Smee-code/SmartHoseLeak/(commit log)

2026-09-08 Replace firmware with merged WiFi-portal + server-uplink sketch
    The two sketches had diverged: the repo copy could POST readings to the
    Django server but had WiFi credentials compiled in, while the newer field
    sketch added a captive-portal WiFi setup but no longer talked to the server
    at all. Flashing the latter would have left the dashboards permanently
    empty, since /api/ingest/ is the only writer of LatestReading, ReadingRollup
    and LeakEvent.
    Merge the uplink into the portal sketch and retire the old one:
    - buildPayload() adapts buildStatusJSON() to the ingest contract, keying
    readings by "module" and the calibration constant by "k"
    - uploadReadings() POSTs on its own timer, skipped in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
    [water_leak_detection_3modules_gsm_wifi.ino]
2026-09-08 Auto-format sketch and set the real device API key
    Applied the IDE's Auto Format (braces moved to their own line, Allman
    style) and filled in the live DEVICE_API_KEY so the sketch is flashable
    straight from the repo without an edit step.
    The formatting is cosmetic: no behavioural change, and it still compiles
    for esp32:esp32:esp32 on core 3.3.11 at 83% program storage.
    Note the key is now in the history. The repo is private, and the key is
    rotatable from the Django admin under Devices if it ever needs revoking.
2026-09-11 Side navigation, map overhaul, CRUD dialogs, and a device-configurable server URL
    A day of work on the facilitator side. Grouped by area:
    NAVIGATION
    - Move the main nav from a crowded top row into a sidebar, grouped
    Monitoring / Management. Below 1024px it becomes an off-canvas drawer
    with a scrim, focus trap, Escape-to-close and a locked background.
    - Responsive pass across every page: no horizontal scroll at any width
    down to 320px. Fixed grid children with min-width:auto letting a wide
    table push the whole page past the viewport.
    LEAK MAP
    - Draw the real municipal boundary of Sison from the official NAMRIA/PSA
    outline, served locally so the map frames the right place with no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
2026-09-11 Toast notifications for server messages, device IP on dashboard, footer design
    - Django messages now surface as toasts instead of a bar across the page.
    They pause while hovered, and anything carrying a password or username
    waits to be dismissed rather than timing out - a temporary password
    vanishing after eight seconds would have lost it for good.
    - The Device status card shows the ESP32's IP as a link to the board's own
    page, kept current by the live poll. Both the laptop's and the board's
    addresses change with the network, and confusing the two is what sends
    you to the wrong /wifi page.
    - The site footer had no styles at all beyond a print rule, so it rendered
    with browser d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
2026-09-11 Complaints become threaded conversations
    Replaces the single-reply ticket screen with a message inbox on both sides.
    A complaint now carries a thread of messages instead of one `response`
    field, so the facilitator and the owner can go back and forth.
    WHY THE ISSUE STAYS THE UNIT
    Grouping strictly by household was considered and rejected: a household
    that reports a leak in March and low pressure in June needs those resolved
    independently, and the dashboard's "Pending complaints" count only means
    something if status belongs to a problem rather than to a person. The
    inbox reads like a messenger; the thread is still one issue.
    - ComplaintMessage: body, author, from_owner, and a read flag per s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
2026-09-11 New complaint moves to a button and a dialog
    The only way to start a complaint was a small "File a different complaint"
    link under the reply box, which is easy to miss and only present once a
    thread is already open.
    - A "New complaint" button now sits in the page header, reachable whether
    or not a conversation is open.
    - The form moved into a dialog, so starting a complaint no longer replaces
    the conversation pane.
    - The empty pane became a proper empty state that also offers the button,
    and reads differently for someone who has never filed anything.
    - The dialog posts to the list URL rather than the current one, so it
    behaves identically from either place, and reopens with the type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
2026-09-11 Redesign the notices list as a grouped timeline
    The list was a stack of identical bordered cards, each repeating its own
    kind in grey text underneath. Nothing distinguished an automated leak alert
    from a reply, and a long list read as a wall.
    - Grouped by day, with Today / Yesterday headings.
    - A timeline rail with an icon node per notice, coloured by kind: red
    warning for automated alerts, blue bell for broadcasts, green chat for
    replies. The icon carries the meaning, so the kind no longer needs a line
    of text under every card.
    - Unread notices are outlined and tagged New. The read flag is now sampled
    before it is cleared, so "new since you last looked" survives the visit
    that ma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
2026-09-11 Search box on the complaints list
    Narrows the conversation list as you type, matching the household owner's
    name or the household ID.
    - Filters the rows already on screen rather than asking the server, so it
    responds on every keystroke and naturally searches *within* the selected
    status chip instead of fighting it.
    - Sticky at the top of the list, so it stays reachable once the list is
    long enough to scroll.
    - Escape clears it, as does the native clear button on a search input.
    - Says "No conversation matches that" rather than leaving an empty box.
    The list already scrolled inside itself at 70vh; confirmed with eight
    threads that it scrolls and the search box stays pinned above them.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
2026-09-11 Drop the footer on the owner's complaints page
    The page ends in the message box, and on a phone a footer underneath pushed
    the compose field up and left a screen of credits below a conversation.
    The footer moved into a template block so a page can opt out; the owner's
    complaints page overrides it with nothing. Every other page keeps it.
    Verified at phone width: no footer on the thread, the page no longer
    scrolls past the viewport, and Home, Notices and My Pressure still have it.
2026-09-11 Back button becomes an inline arrow instead of its own row
    A wide "<- Back" button with no flex-basis on the title next to it meant the
    title wrapped onto a second line, leaving the button stranded above the
    heading on a phone.
    It is now a 32px circular arrow immediately left of the title, the way a
    phone detail screen usually reads, and the title has a flex-basis so it
    stays on that line. Applied to both the owner's and the facilitator's
    conversation, and still hidden on desktop where the list is already beside
    the thread.
2026-09-12 Make the pressure sensors diagnosable from the serial line
    The board was reporting 0.00 bar on all three modules and there was no way
    to tell whether that meant "no water pressure" or "no sensor" - a correctly
    wired transducer outputs 0.5 V at rest, which converts to exactly 0.00 bar,
    the same as an unconnected pin. Nothing in the firmware exposed the raw ADC
    count, which is the only thing that separates them.
    Taking sensor_test.ino as the reference, which does show raw counts:
    - Average 16 ADC samples per reading instead of one. A single ESP32 read
    swings by hundreds of counts; this is what makes the reference sketch's
    numbers steady.
    - Put the raw count and both voltages on every ser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
    [water_leak_detection_3modules_gsm_wifi.ino]
2026-09-12 Calibrated ADC reading and a per-sensor zero point
    With the raw counts now visible, all three sensors read ~350 counts steadily
    - a real signal, not a dead pin. But that converts to 0.423 V at the sensor,
    below the 0.5 V the datasheet calls zero, so every reading clamped to 0.00
    bar and the bottom ~0.3 bar of range was unreachable.
    Two causes, both addressed:
    - The raw count was being converted by hand, which assumes a perfectly
    linear 0-3.3 V ADC. The ESP32's is not; it reads low, worst at the bottom
    of the range, which is exactly where a pressure sensor sits with no water.
    analogReadMilliVolts() applies the calibration burned into the chip at the
    factory instead of assuming.
    - S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
    [water_leak_detection_3modules_gsm_wifi.ino]
2026-09-12 Put SQLite in WAL mode to stop "database is locked" dropping readings
    The ESP32 posts every two seconds and every open dashboard polls just as
    often. SQLite allows a single writer, and the database sits on a USB drive
    where writes are slow, so those collided: the loser raised "database is
    locked", the ingest returned 500 and that batch of readings was lost.
    - journal_mode=WAL lets readers carry on while a write is in progress,
    which removes nearly all of the contention.
    - synchronous=NORMAL is the matching setting under WAL: still crash-safe,
    without an fsync per transaction, which is what hurts most on removable
    media.
    - busy timeout raised from the default 5s to 30s, so a slow write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
2026-09-14 The ESP32 finds the server by itself
    The laptop's address comes from whatever router it joins, so it moves - four
    times in one day here. Each time, the board kept posting readings to the old
    address until somebody noticed and retyped it, and today that meant two days
    of silence with the dashboard showing stale values.
    The board now asks instead. It broadcasts a probe, the server answers with
    the address to use, and the board saves it to flash.
    - Server: a small UDP listener on 18830, started by runserver only when
    bound to all interfaces - on localhost there is nothing for a device to
    find, and advertising an unreachable address would be worse than silence.
    It answers with the addres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
2026-09-14 Show the connection on the device's own dashboard
    The board's page said only "WiFi: Connected" - not which network, not its own
    address, not where it was sending readings. Those are exactly the things that
    change without anyone touching the board: the network when it is moved, the
    server address when the laptop's address moves.
    The page now opens with a panel giving:
    Network the SSID it joined, with signal strength in words and dBm
    This device its own IP
    Sending to the server address currently in use
    Last upload the result, and when that failed, what the last search for
    the server turned up
    So "why is the dashboard not updating" is answerable from one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
    [water_leak_detection_3modules_gsm_wifi.ino]
2026-09-14 Set the low-supply threshold from the dashboard, not the sketch
    The pressure at which a line counts as "low supply" is a property of the
    site, not of the code. A gravity-fed line sits at roughly 1 bar per 10 m
    its source is above it, so the right figure differs from line to line and
    is only knowable once the line exists and has been watched for a day.
    It was a single compiled-in constant at 1.5 bar - a value that suits a
    pressurised municipal main. A healthy gravity-fed barangay line runs at
    0.3-1.0 bar, so all three lines reported Low Water Supply permanently and
    the alert became noise. Changing it meant a laptop, a cable and a reflash.
    Now each line owns its own threshold, editable at Da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
    [water_leak_detection_3modules_gsm_wifi.ino]
2026-09-16 One hose line per household, each with its own device
    The rig was three sensor pairs sharing one board along a single run, so a
    household was assigned to whichever stretch it happened to sit on and a leak
    could only be narrowed to "somewhere between 15 m and 30 m". Each house now
    has its own hose from the main source and its own board. A leak is
    attributed to a household instead of to a position - more useful, because it
    names a door to knock on, and more honest, because two sensors at one end of
    a pipe cannot locate a hole along it.
    Distance markers, length and "leak location" are gone throughout. They
    described the old geometry and describe the new one not at all.
    The dashboard's three c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
    [mark_offline.py]
2026-09-16 The map draws one hose per household, from the main source
    Every household now has its own hose leaving one point, but the map was
    still grouping houses by module and chaining each group into a single run.
    With one board per house every line reports module 1, so all six households
    collapsed onto one branch - drawing plumbing that does not exist, and
    implying that a leak upstream affects everyone below it.
    Each hose is now drawn straight from the source to its own house, in that
    household's colour. A hose with no board fitted is dashed: the pipe is
    there, nothing is watching it, and that has to read as "not yet" rather than
    as a fault.
    The recorded source is renamed from "Main valve" to "Ma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
2026-09-16 Send notices by SMS, and text a household when their line leaks
    An in-app notice is only seen by somebody who opens the app. A leak at two
    in the morning cannot wait for that, so the household is now texted as well.
    Through a SIM800L on the SERVER, not the one on the board. The board's module
    knows module numbers and bar readings; the household database lives here, so
    this is the only place that can address a message to a named person and write
    a sentence they can act on. The board's module stays as a last resort for
    when it cannot reach the server at all.
    One compose screen, two channels, rather than a separate SMS tab. A
    facilitator writing "water is off until 3pm" is doing one thing, an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
    [runserver.py, send_sms.py]
2026-09-16 Drop the single Device status tile from the dashboard
    It described one board. There is now one per household, so a single global
    answer could only be wrong or meaningless - and the Households table below
    already answers the same question per house, which is the resolution that
    actually matters when deciding whose water is unwatched.
    The board's IP address is not lost with it: it moves into that table's
    Device column, under "live", still a link to the board's own page and still
    kept current by the poll. The address changes whenever the network does, and
    that is exactly when somebody needs to open it.
    The offline toast stays. A board dropping off is worth interrupting for
    wherever the facili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
2026-09-16 Register a household, its hose and its board in one action
    Adding a house, laying its hose and fitting its board is one real-world
    event. It took four steps across three screens plus the Django admin - and
    the last step was impossible from the UI at all, since a board could only be
    created in /admin/, which was also the only place its key could be read.
    Three screens is how a household ends up on the books with no line and
    nobody notices for a week.
    The "Supply line" dropdown is gone from the household form. A line serves
    exactly one house now, so picking one from a list of lines that each belong
    to another house was a question with a single right answer; the line is
    created with the househ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
2026-09-16 Per-household firmware: one sensor pair, four tests, a valve, and a claim code
    The board now watches one household's hose and is told who it is, instead of
    carrying three sensor pairs and a compiled-in identity.
    Identity comes from a claim code. The API key is 43 mixed-case characters
    with dashes and underscores, and asking somebody to type that on a phone in
    a yard produces a 401 - which on the serial monitor is indistinguishable
    from a wrong server address. Instead the dashboard issues a six-character
    single-use code, the board hands it to /api/claim/ once it is on the network,
    and the server hands back the real identity, which the board keeps in flash.
    The key is never typed, never copie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
    [water_leak_detection_3modules_gsm_wifi.ino]
2026-09-16 Bring the runbook in line with the firmware it describes
    Section 9 still told the operator to calibrate with C1 / A / F before
    trusting any leak alert. Those commands do not exist any more, and neither
    does the method behind them - so the first thing the guide asked for was
    impossible, which is worse than saying nothing. It now covers the commands
    the sketch actually has: zeroing, the valve, and simulation.
    Section 15 was a plan for "one ESP32 per zone, three lines each", written
    when the rig shared a board between lines. The design passed it. It now
    records what the system actually does, including why boards are numbered
    separately from households and the one part that genuinely does not s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
2026-09-16 Let the board run correctly before the valve and GSM arrive
    The sensors are wired and the valve and SIM800L are not, and a board in that
    state has to behave correctly rather than almost correctly. Two switches,
    because both failure modes are quiet ones.
    With no valve, the sealed-line test would close nothing, then time the
    pressure drift of an OPEN hose for five minutes and report it as a leak.
    Phantom leaks are worse than no leak detection: they teach everyone to ignore
    the alerts, including the real ones. The test is the only one of the four
    that needs the valve, so the other three keep running.
    With no GSM module, every AT command waits out a timeout that never ends,
    inside a loop that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
    [water_leak_detection_3modules_gsm_wifi.ino]
2026-09-16 Send SMS through Semaphore instead of a modem on this machine
    The SIM800L was the right choice while the server was a laptop: nothing per
    message on an unli-text promo, and it works with no internet at all. It
    cannot survive hosting. pyserial opens a port on the machine executing the
    code, so the modem and the server have to be the same machine - a container
    in a data centre has no USB port, and no amount of plugging the module into
    a laptop in Surigao changes that. A gateway works from both, so one build
    now serves the prototype and any deployment with nothing to migrate.
    What is given up is SMS during an internet outage, which is exactly when it
    matters most. The answer is the SIM800L on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
2026-09-16 Show unread conversations the way a message list does
    The inbox marked an unanswered thread with a small count badge, in a row that
    already carries an avatar, a name, a date, a subject and a status pill. It
    was easy to scan straight past - and the one question this list has to answer
    without being read is "has somebody written to me and not been answered".
    An unread row now gets weight, colour and a dot at once: a tinted background,
    a bar down its left edge so the unread ones line up as a column rather than
    each having to be judged on its own, a bold name and subject, and the count
    kept because how many is more use to a facilitator triaging than a plain dot.
    The open thread wins over the u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
2026-09-16 Stop a conversation filling the Recently sent panel
    Every reply written in a complaint thread also becomes a notice for that
    owner, and each one was rendered as a full card: a title like "Reply to your
    complaint CMP-260911-96A2" wrapped around a body of "ok". The list meant for
    notices the facilitator composed was, in practice, made entirely of them -
    seven short replies filled the panel, and it grew with every reply ever sent.
    Replies are now one compact row each, linking to the thread, because the
    thread is where a reply can actually be acted on. Consecutive replies to the
    same complaint fold into one row with a count of the rest. Only consecutive
    ones: a run broken by something else is t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
2026-09-16 Compact the compose form so the whole of it fits on screen
    Choosing recipients, writing a notice and sending it is one short task, and
    it filled a tall column: seven households in a 190px scrolling box that
    showed five of them, a five-row message box, two checkboxes each with a
    paragraph beneath, a button, and two more paragraphs of advice.
    Households now wrap across the width. Seven fit in two rows with nothing
    hidden and no scrollbar; the cap only bites past roughly twenty, where a full
    list would be the thing pushing the message box off the screen.
    The two channels and the send button share one line. Deciding where a notice
    goes and sending it are one action, and stacking them put three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
2026-09-16 Choose recipients by typing, not by hunting a checkbox grid
    A grid of checkboxes was fine at seven households and stops working at the
    twenty to fifty this is meant to serve: finding one becomes hunting, and the
    compose form grows with the barangay.
    A modal would have solved the space and cost something else - the choice
    would sit behind a dialog, so you could not see who you had picked while
    writing the message, and the most common action would gain a click.
    So: a token field. Type to filter on name or household ID, Enter or a click
    adds a chip, the x removes one, Backspace in an empty box removes the last.
    Chips stay in view beside the message. "All active households" stays a
    single tick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
2026-09-16 Compact the two panels on a household's page
    household, so their own page is where all of their replies land together -
    and each was a card wrapped around one line like "ok". Five complaints and
    seven notices ran past the bottom of the screen.
    Both panels are rows now, and the notices reuse the folding already built
    for the Notices page: consecutive replies to the same complaint become one
    row with a count. Seven notices render as four rows; the pair of panels is
    349px and the page fits in 880.
    _recent_notice_feed() takes a queryset so this page can pass the household's
    own notifications through the same folding rathe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
2026-10-01 Keep the frontend-design skill with the project
    Installed from anthropics/skills. It is design direction rather than code:
    a two-pass process that makes you write a palette and type plan and check it
    for genericness before building, a calibration list of the traits that mark
    generated design, and guidance on interface writing.
    Committed so it travels with the repository. Until now it existed only on
    this drive, and a clone elsewhere - or a drive failure - would have meant
    re-running the installer to get it back.
    The installer also wrote .agents/skills/, a second copy for Cursor, Copilot
    and similar. That one is ignored: this project is worked on through Claude
    Code, which reads .claude/ski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
2026-10-01 Stop the pressure tab saying everything twice
    Seven tiles across the top showed the same seven households, the same
    pressure, the same flow and the same status as the seven rows below them.
    Both are kept, as asked - they now answer different questions. The tiles are
    what is reading NOW. The table is the record: every household, the psi and
    the links to each one, which the tiles never carried.
    A tile with no reading collapses to its own name. Six cards of four empty
    wells buried the one line that was live and made a rollout going to plan look
    like six faults; a card's size should be how much it has to say. The
    collapsed state is cleared by the poll the moment a reading arrives, so a
    line tha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
2026-10-01 Make the households page about the households
    Seven saturated red Delete buttons ran as a stripe down the right edge of a
    page whose job is to show people, sending the eye straight to the one action
    nobody opens this page to take. Delete stays exactly where it was and does
    exactly what it did - it now rests as a quiet control and turns red the
    moment it is hovered or focused. Verified: transparent at rest, #b3261e on
    hover AND on keyboard focus, and the confirmation dialog still carries a full
    danger button, which is where the weight belongs.
    The Supply line column is every row's id and owner run together - "HH-001 -
    Maria Santos" sitting beside HH-001 and Maria Santos. It is the line's rea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
2026-10-01 Redesign the lines page, and unbreak three lines while doing it
    The page announced itself as "Supply lines and distance markers" and then
    explained that "each line is one sensor module on the ESP32" and that the
    water source "is the 0 m mark". None of that has been true since one board
    per household: distance markers are gone and a leak names a household. A
    heading that describes something the system does not do is worse than none.
    Three of the seven lines could not be saved at all. 0012 rebuilt the lines
    with a hardcoded list of hex values rather than reading DEFAULT_COLOR_CYCLE,
    and three were not in the palette the form offers - so Edit showed no colour
    selected, and Save returned "Selec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
2026-10-01 Make a complaint thread about the problem, not the person
    The inbox listed five rows all reading "Maria Santos" with the thing that
    told them apart - the subject - set in grey underneath. A thread here is
    one problem, and one household can have five open at once, so the subject
    now leads and the name follows it. The thread header was reordered to
    match, so the row clicked is the row now at the top.
    The context strip read "HH-001 - Purok 1, Lower Dakong Patag - HH-001 -
    Maria Santos - +639171234567": the household id twice, the owner again.
    It is now the household link, the address, and the number as a tel: link
    pushed to the right, which is what the facilitator reaches for mid-read.
    Timest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
2026-10-01 Make the landing page about water, and stop it naming residents
    The public page opened with a tracked-out locale label, a centred headline
    over a pale gradient, three big-number cards and four identical rounded
    cards holding a dot, a triangle, a flag and an envelope. Nothing on it was
    about water; swap the nouns and the same page sells a parcel tracker.
    The hero is now the one idea the system runs on, drawn: pressure holding
    steady through the night and then sliding away while no tap is open. That is
    what each board watches for, it is why the project exists, and it lands
    before a word of the copy is read. Inline SVG, because this is a PWA with an
    offline page installed on phones where the s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
2026-10-01 Let card heads wrap, so a control cannot push out of its own card
    On the Lines page at phone width, "Register a board" and its label field ran
    out through the right edge of the Devices card and landed on the table
    below. The head measured 346px of content inside a 337px card.
    Fixed where it comes from rather than on that page. .card-head was a flex
    row with no wrap anywhere in the system, which left it no way to fail but to
    push its control through the card edge - every card head carrying a button
    had the same bug waiting at some width, and the heading and the control are
    not one indivisible line. There is no width at which overflowing beats
    dropping to a second row.
    .inline-form had the s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
2026-10-01 Fix the sidebar logo, hidden behind a comment that was not one
    I broke this in the routing change. Django's {# #} comment is single-line
    only; written across two lines it is not a comment at all, it is text. The
    note I left above the sidebar brand therefore rendered - four lines of
    commentary beside the logo, pushing it from x=14 to x=202 and out of the
    header, on every signed-in page for both roles. The markup looked correct,
    which is exactly why it got through.
    Both of my multi-line {# #} comments are now {% comment %} blocks. The other
    was inside the landing page's SVG, where the stray text happened not to
    paint, so nothing showed - it was the same mistake with a luckier outcome.
    Added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
2026-10-02 Give wrong addresses a real page instead of a traceback
    A mistyped address produced Django's development error page, which besides
    looking like a fault printed every URL pattern in the project to whoever
    typed it - api/claim/, the device key endpoints, all of it. With DEBUG off
    it would have produced Django's bare "Not Found" instead, which is not much
    better. Four pages now: 404, 403, 400 and 500.
    No giant status numeral. That is the stock treatment and it puts a protocol
    code at the largest size on the screen, above the sentence that says what
    actually happened. The code is at the bottom, small, because it is what gets
    quoted when somebody reports the problem and nothing else about it is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
2026-10-02 Name the https trap where it happens, instead of in a stack trace
    Opening the LAN address on a phone produced ERR_SSL_PROTOCOL_ERROR and filled
    the server window with "code 400, message Bad request version
    ('\x16\x03\x01...')". Those are the same event said twice: the browser sent a
    TLS handshake and this server read it as a request line. Nothing in the
    project is wrong - it serves HTTP, returns 200, sends no HSTS header, no
    upgrade-insecure-requests and has no SSL redirect - and no server-side
    setting can stop a browser choosing https.
    So the startup banner now says so next to the address it prints, which is
    where somebody is standing when they get it wrong, and GUIDE 12e carries the
    sympt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
    [runserver.py]
2026-10-02 Trust ngrok's current domain for CSRF, and write down how to use it
    VS Code's port forwarding delivered static files but silently dropped every
    HTML page - app.css arrived over the tunnel, /login/ never did, while both
    answered instantly on 127.0.0.1 and on the LAN. That is not something this
    project can fix, so the guide now covers ngrok as the way to put the system
    on a phone.
    ngrok hands out *.ngrok-free.dev now, not the *.ngrok-free.app this list was
    written against, so the first login through it would have failed the CSRF
    origin check - and that failure says nothing about the tunnel being the
    cause, which is the whole reason this block exists. Both are trusted now,
    and the old .ngrok.i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
2026-10-02 Take the house count out of the headline, where it was already wrong
    The hero read "Seven houses." The barangay is on six lines now, so the one
    sentence nobody thinks to edit was contradicting the live counts sitting
    directly underneath it. A number carved into a headline goes stale on its
    own and makes the whole page look unmaintained.
    It now describes the shape of the system instead, which does not change with
    the roll-out: one hose to every house, a sensor on every hose. The counts
    stay in the strip below, where they come from the database and are right by
    construction.
    Also fixed the labels in that strip, which were fixed words beside a live
    number and read "1 Boards fitted" - exactly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
2026-10-05 Rebuild the landing page as an instrument, for the defence panel
    The page read as generated: a big-number/small-label count strip (the stock
    hero treatment), system type with no personality, rounded role cards, and a
    chart that sat on the page rather than being the point of it. This rebuilds
    it around one idea - the page is the face of a chart recorder, and the one
    pattern the whole system turns on is drawn on it: pressure sliding away while
    no tap is open.
    Direction, type, hero and audience were chosen with the person: field
    instrument, one self-hosted display font, keep and redraw the trace, aimed at
    a capstone defence panel.
    - Saira, a technical grotesque, self-hosted from static/font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
2026-10-05 Animate the recorder: a pen that draws, and an alarm that pulses
    The landing page already revealed its trace on load; this makes that reveal
    read as what it is. A bright pen tip now rides the leading edge of the line
    as it is drawn - the chart-recorder pen moving across the paper - and fades
    as it reaches the leak. At the flagged point a ring pulses outward, slowly
    and on a loop, the way an instrument's alarm light does.
    Deliberately two motions, not a scatter of them: the skill warns that
    fade-and-slide entrances on every element read as generated. These are one
    cohesive moment - draw, reach the leak, alarm - and the pulse is the single
    thing on the page meant to keep catching the eye, whi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
2026-10-28 Add admin console, notifications, and a bilingual passwordless sign-in
    Brings the accumulated work into the repo in one place:
    - Admin console: barangays, accounts and facilitators, work orders,
    announcements, audit and error logs, and system settings.
    - Household activation, visit routing, and per-barangay water sources.
    - Two-step sign-in codes (OTP) sent by text or email, with the SMS
    gateway switched to iprogSMS.
    - Sign in with either an email or a username, and self-service password
    reset by an emailed link (built from the request host for the tunnel).
    - English/Filipino language toggle across the landing and sign-in flow,
    with Django gettext catalogs under locale/fil/.
    - Maint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
2026-10-28 Add automatic leak detection: Phase 1 (server) and Phase 2 (firmware)
    Phase 1 – server side:
    - Add WATER_RUNNING alert status to Segment.Status
    - Add 6 detection-settings fields to SystemSetting (flow warn/leak minutes,
    nightly valve-test hour, grace period, pressure-drop threshold, auto-close flag)
    - Migration 0035 for the new fields and status choices
    - Push detection settings back to the board on every ingest reply (_device_config)
    - Auto-send email + SMS on WATER_RUNNING and POSSIBLE_LEAK events
    - Admin console: Leak detection card on System page (DetectionSettingsForm)
    - Admin households: restore full board-label section when creating a household
    - 189 tests passing (WaterRunningAle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
2026-10-28 Add unit labels (minutes, bar, 0–23) to detection settings field names
    The admin console now shows the unit next to each label so it is clear
    what the numbers mean without reading the help text.
2026-10-28 Show every active household as a tile on the pressure page
    The tiles were iterating over segments, so households whose segment's
    barangay was missing or mismatched never appeared in the live cards
    even though they showed in the table below. Now both the tiles and
    the table iterate over the same households queryset, so every
    activated household gets a card.
2026-10-28 Set barangay on the hose line when a household is registered
    The segment created by attach_hardware was missing its barangay, so
    it did not appear in the facilitator's scoped segment queries and the
    pressure page tiles skipped it.
2026-10-28 Show Offline instead of Under Maintenance on pressure tiles; fix SW to serve fresh JS
    - Pressure tile pill now shows "Offline" for maintenance status instead of "Under Maintenance"
    - Maintenance note text simplified to "Alerts paused for this line."
    - Service worker switched from cache-first to network-first for static assets so code updates take effect immediately without needing a manual cache clear
2026-10-28 Relabel MAINTENANCE status as "Offline" everywhere admin and facilitator see it
    get_status_display() now returns "Offline" for maintenance across all server-rendered
    segment and event pills, so the pressure tiles, lines list, events and dashboards
    no longer show "Under Maintenance". Reverted the JS pill special-case since the API
    status_label now carries "Offline" on its own.
2026-10-28 Relabel maintenance status as "Offline" on the map popup too
    Last remaining display label: the facilitator map's STATUS_LABEL still read
    "Under Maintenance". The toggle buttons stay labelled "Maintenance" since they
    are the control that parks a line, not a status readout.
2026-10-29 Add manual valve control and realistic test-alert tool (admin)
    Manual ball-valve open/close (admin-only, server + firmware):
    - Segment.valve_command parked and handed to the board on its config reply;
    cleared once the board reports the commanded valve state. A close latches
    (valveReason="manual"), persisted to NVS so an admin-sealed line stays shut
    across a reboot; firmware reports valve_state and restores the latch on boot.
    - Open/Close buttons on the admin pressure tiles, with a confirm on close.
    Send test alert (admin-only):
    - Fires a genuine household notification (in-app + SMS + email + push) for
    either watched condition without a board or a real leak, using the real
    _notify_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
    [water_leak_single_wifi.ino]
2026-11-11 Firmware: decay hold, server discovery after a move, 15 s uploads with fast valve poll
    - The nightly test holds the valve shut when it finds a leak (reason
    "decay") until somebody opens it; valve_reason rides on every upload.
    - A moved board finds the server again: UDP discovery (SHL-DISCOVER? on
    18830, matching core/discovery.py) at join and after three unanswered
    uploads. Public https:// addresses are left alone.
    - The setup hotspot comes up about a minute after the network is lost
    while running, beside the station, and closes on rejoin. Detection and
    the valve keep running in hotspot mode.
    - A blank setup code keeps the board's identity; a new one re-claims it.
    - Routine uploads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
    [water_leak_single_wifi.ino]
2026-11-11 Valve control for every role, demo owner, Filipino everywhere, 15 s cadence, QA fixes
    Valve: households, facilitators and the admin see the valve state with its
    reason and can open/close it; an admin close locks the line until the admin
    opens it. Audit log and household notice on every action. Firmware's
    decay/manual reasons are stored and described on screen.
    Demo owner: setup_demo_owner builds HH-DEMO with a furnished portal and a
    password-only login (no phone, no email), refused unless DEBUG.
    Filipino: every template, flash message, form label, browser string
    (JavaScript catalog) and generated notice/SMS is translatable; 1,196
    strings translated. Households carry a language (Filipino by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
2026-11-12 Permanent Delete beside Archive, and a duplicate-registration warning
    Admin Households list and the Archive page both get a red Delete: the
    household ID must be typed back (checked on the page and on the server),
    then the household, its login, its hose line with every reading and event,
    its complaints, notices and work orders go; the board is kept as a spare.
    The facilitator's Delete now removes the hose line too (shared helper).
    Registering a contact number or email already on a household - archived
    or not - stops with a warning that names the match, links to it, or offers
    "Restore it instead" for an archived one; "Register anyway" lets a genuine
    second household on a shared phone through.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
2026-11-12 Survive a household whose hose line is missing; add repair_links
    On the hosted site a household pointed at a line that was not in the
    database (left by a restore), and every owner-portal page crashed with
    "Segment matching query does not exist". owner_required now clears such a
    pointer and the portal opens with "no line yet". New management command
    repair_links clears every dangling household -> line and line -> board
    pointer; the Restore button runs it after loading a backup. Tests in
    core/tests_households.py; GUIDE 3d and changelog.
    [repair_links.py]
2026-11-12 Owner sets up or moves the board from the portal
    New board: Settings > My device collects the home WiFi on the phone (never
    sent to the server) and builds a link to the board's hotspot page with the
    WiFi, server address and setup code in the query string; the board's page
    now pre-fills from it, so the owner only presses Save & connect. Works on
    iPhone and Android (a plain link, no Bluetooth). Session storage keeps the
    typed WiFi across an accidental reload.
    Online board: "Change WiFi" on the device card parks the new network on the
    board's record (Device.pending_wifi_*), handed over on the upload reply with
    a change id; the board tries it for 25 s, falls back to the old network if
    it fails,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
    [water_leak_single_wifi.ino]
2026-11-12 "Open the board's page" button on the owner's device card
    Shown in every state. Links to http://192.168.4.1/ (the board's hotspot)
    until the board is online, then to the address the board reports on the
    home WiFi, which a phone on that WiFi can open; the note under it says
    which. Firmware reports lan_ip on every upload; Device.lan_ip (migration
    0045). Tests, Filipino strings, GUIDE 9h and changelog.
2026-11-12 repair_links also clears notice and work-order pointers, then reports what SQLite still sees
    After the PythonAnywhere recovery the six damaged hose lines were gone and
    migrate failed again on notifications and a work order that pointed at
    them. The command now nulls those optional pointers too and finishes with
    PRAGMA foreign_key_check, listing any broken reference it cannot clear so
    the next migrate failure is never a surprise. Test and GUIDE 3d.
    [repair_links.py]
2026-11-14 Firmware: hold the valve relay for the valve's full travel, not 0.6 s
    The ACARPS motorised ball valve (DC 12-24 V, three wires, running time
    15 s) moves only while power is held on its CLOSE or OPEN wire; its limit
    switch stops the motor. The sketch pulsed the relay for 600 ms, so the ball
    turned a few degrees and stopped while the board - which has no feedback -
    reported "closed". Each relay is now held for VALVE_TRAVEL_MS (18 s), with
    the board's own page still served during the move. GUIDE: the "valve did
    not move" entry in section 12, the valve in section 13, corrected cadence
    figures there, changelog.
    [water_leak_single_wifi.ino]
